piit79/SofleKeyboard/Sofle_RGB_v3/README.md

## Sofle RGB v3

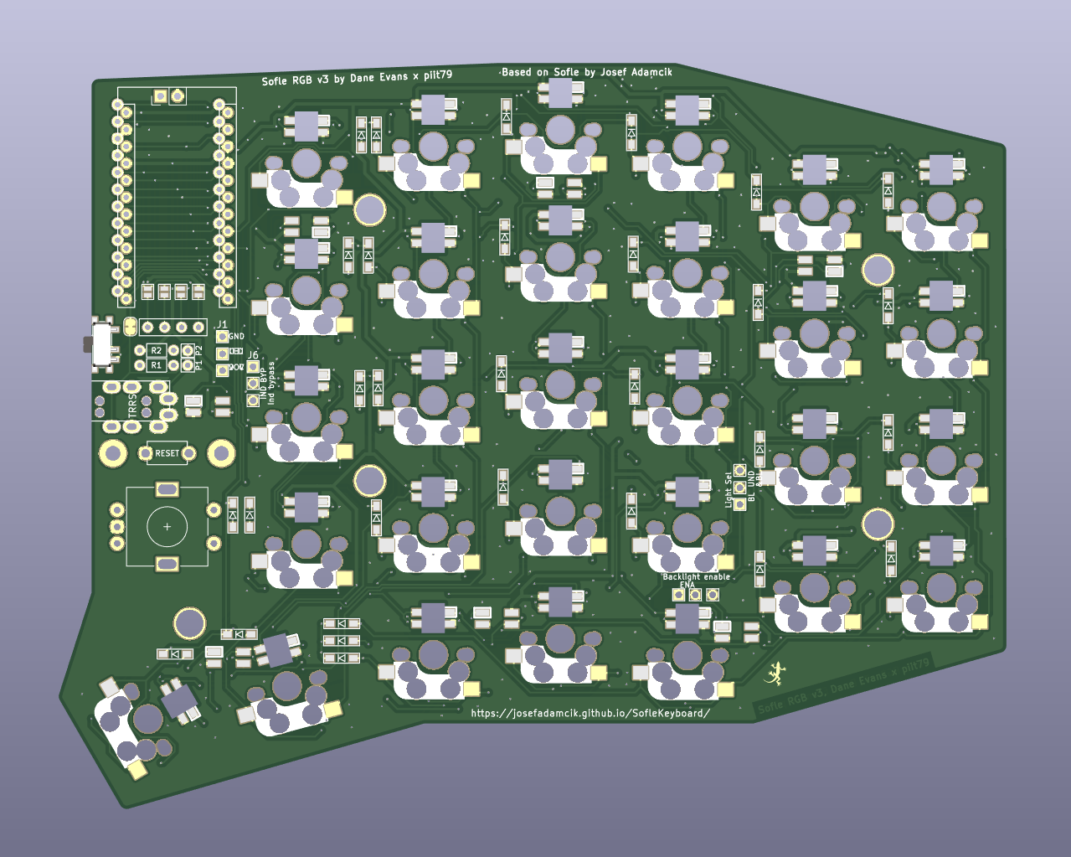
[picture p1: Sofle_RGB_v3/PCB/SofleKeyboard_RGB_v3.png]
Sofle RGB v3 PCB


This is a variation of the Sofle RGB with the more aggressive "pinky stagger" of the Sofle v2, plus a few other modifications:

* Support for a SMD power switch
* Battery connector next to the controller footprint (intended for a small battery that fits underneath the controller)
