piit79/SofleKeyboard/Sofle_RGB_v3/Case/Acrylic/README.md

## Acrylic Case for the Sofle RGB V3

There are 2 main constructions of the case:

  * Partial, with gaps between the switch plates and PCBs, and/or PCBs and bottom plates
  * Full sandwich with no gaps

Each construction can also be made in two variants:

  * Standard
  * Tenting - with bottom plates that have lugs for tenting legs

### Partial Case

  * 3 mm acrylic [switch plates](https://github.com/piit79/SofleKeyboard/blob/sofle_rgb_v3/Sofle_RGB_v3/Case/Acrylic/SofleKeyboard_RGB_v3-switch-plates.svg) (with 2 or 3 mm acrylic covers)
  * Optional 2 mm switch plate foams (same file as for the switch plates, just without the covers)
  * 3 mm acrylic bottom plates - [standard](https://github.com/piit79/SofleKeyboard/blob/sofle_rgb_v3/Sofle_RGB_v3/Case/Acrylic/SofleKeyboard_RGB_v3-bottom-standard-plates-screws.svg) or [tenting](https://github.com/piit79/SofleKeyboard/blob/sofle_rgb_v3/Sofle_RGB_v3/Case/Acrylic/SofleKeyboard_RGB_v3-bottom-tenting-plates-screws.svg)

Required mounting hardware:

  * 10x M2x6 mm brass standoffs (to go between switch and bottom plates)
  * 4x M2x10 mm brass standoffs (for the acrylic covers)
  * 28x M2x6 mm screws

### Full Sandwich Case

  * 3 mm acrylic [switch plates](https://github.com/piit79/SofleKeyboard/blob/sofle_rgb_v3/Sofle_RGB_v3/Case/Acrylic/SofleKeyboard_RGB_v3-switch-plates.svg) (with 2 or 3 mm acrylic covers)
  * 2 mm switch plate foams or acrylic upper mid plates (same file as for the switch plates, just without the covers)
  * 2 or 3 mm bottom mid layer (foam or acrylic) - [with battery cutouts](https://github.com/piit79/SofleKeyboard/blob/sofle_rgb_v3/Sofle_RGB_v3/Case/Acrylic/SofleKeyboard_RGB_v3-mid-plates-battery.svg) or [without them](https://github.com/piit79/SofleKeyboard/blob/sofle_rgb_v3/Sofle_RGB_v3/Case/Acrylic/SofleKeyboard_RGB_v3-mid-plates-no-battery.svg)
  * 3 mm acrylic bottom plates - [standard](https://github.com/piit79/SofleKeyboard/blob/sofle_rgb_v3/Sofle_RGB_v3/Case/Acrylic/SofleKeyboard_RGB_v3-bottom-standard-plates-inserts.svg) or [tenting](https://github.com/piit79/SofleKeyboard/blob/sofle_rgb_v3/Sofle_RGB_v3/Case/Acrylic/SofleKeyboard_RGB_v3-bottom-tenting-plates-inserts.svg)

The bottom mid layer has two variants - with a cutout for the battery underneath the controller (for 3 mm acrylic) and without it (for 2 mm acrylic).

Required mounting hardware:

  * 10x M2x3Lx3.5D mm heat-set brass threaded inserts (3 mm long, 3.5 mm diameter; for the bottom plates)
  * 4x M2x10 mm brass standoffs (for the acrylic covers)
  * 10x M2x12 mm screws (these go through the switch plates all the way into the bottom plates)
  * 8x M2x6 mm screws (for the acrylic covers)
