piit79/SofleKeyboard/(list of files, cad)

Other CAD files:
Sofle_Choc_v2.2/Case/Sofle_Choc_v2.2_acrylic_bottom.dxf
Sofle_RGB_v3/Case/Acrylic_Cover.dxf
Sofle_RGB_v3/Case/PCBBottom/SofleKeyboard_RGB_v3_Bottom.dxf
Sofle_Choc_v2.2/Case/Sofle_Choc_v2.2_acrylic_cover.dxf
Sofle_RGB_v3/Case/Acrylic/SofleKeyboard_RGB_v3-mid-plates-no-battery.dxf
Sofle_RGB_v3/Case/Acrylic/SofleKeyboard_RGB_v3-switch-plates.dxf
Sofle_RGB_v3/Case/Acrylic/SofleKeyboard_RGB_v3-bottom-tenting-plates-inserts.dxf
Sofle_RGB_v3/Case/Acrylic/SofleKeyboard_RGB_v3-mid-plates-battery.dxf
Sofle_RGB_v3/Case/Acrylic/SofleKeyboard_RGB_v3-bottom-standard-plates-inserts.dxf
Sofle_RGB_v3/Case/Acrylic/SofleKeyboard_RGB_v3-bottom-standard-plates-screws.dxf
Sofle_RGB_v3/Case/Acrylic/SofleKeyboard_RGB_v3-bottom-tenting-plates-screws.dxf
