piit79/SofleKeyboard/(list of files, drawings)

Other design files:
Sofle_Choc_v2.2/PCB/SofleKeyboard.dsn
