piit79/SofleKeyboard/Sofle_RGB_v3/PCB/SofleKeyboard_RGB_v3.kicad_pcb

## KiCad design Sofle_RGB_v3/PCB/SofleKeyboard_RGB_v3.kicad_pcb (2024-08-11)

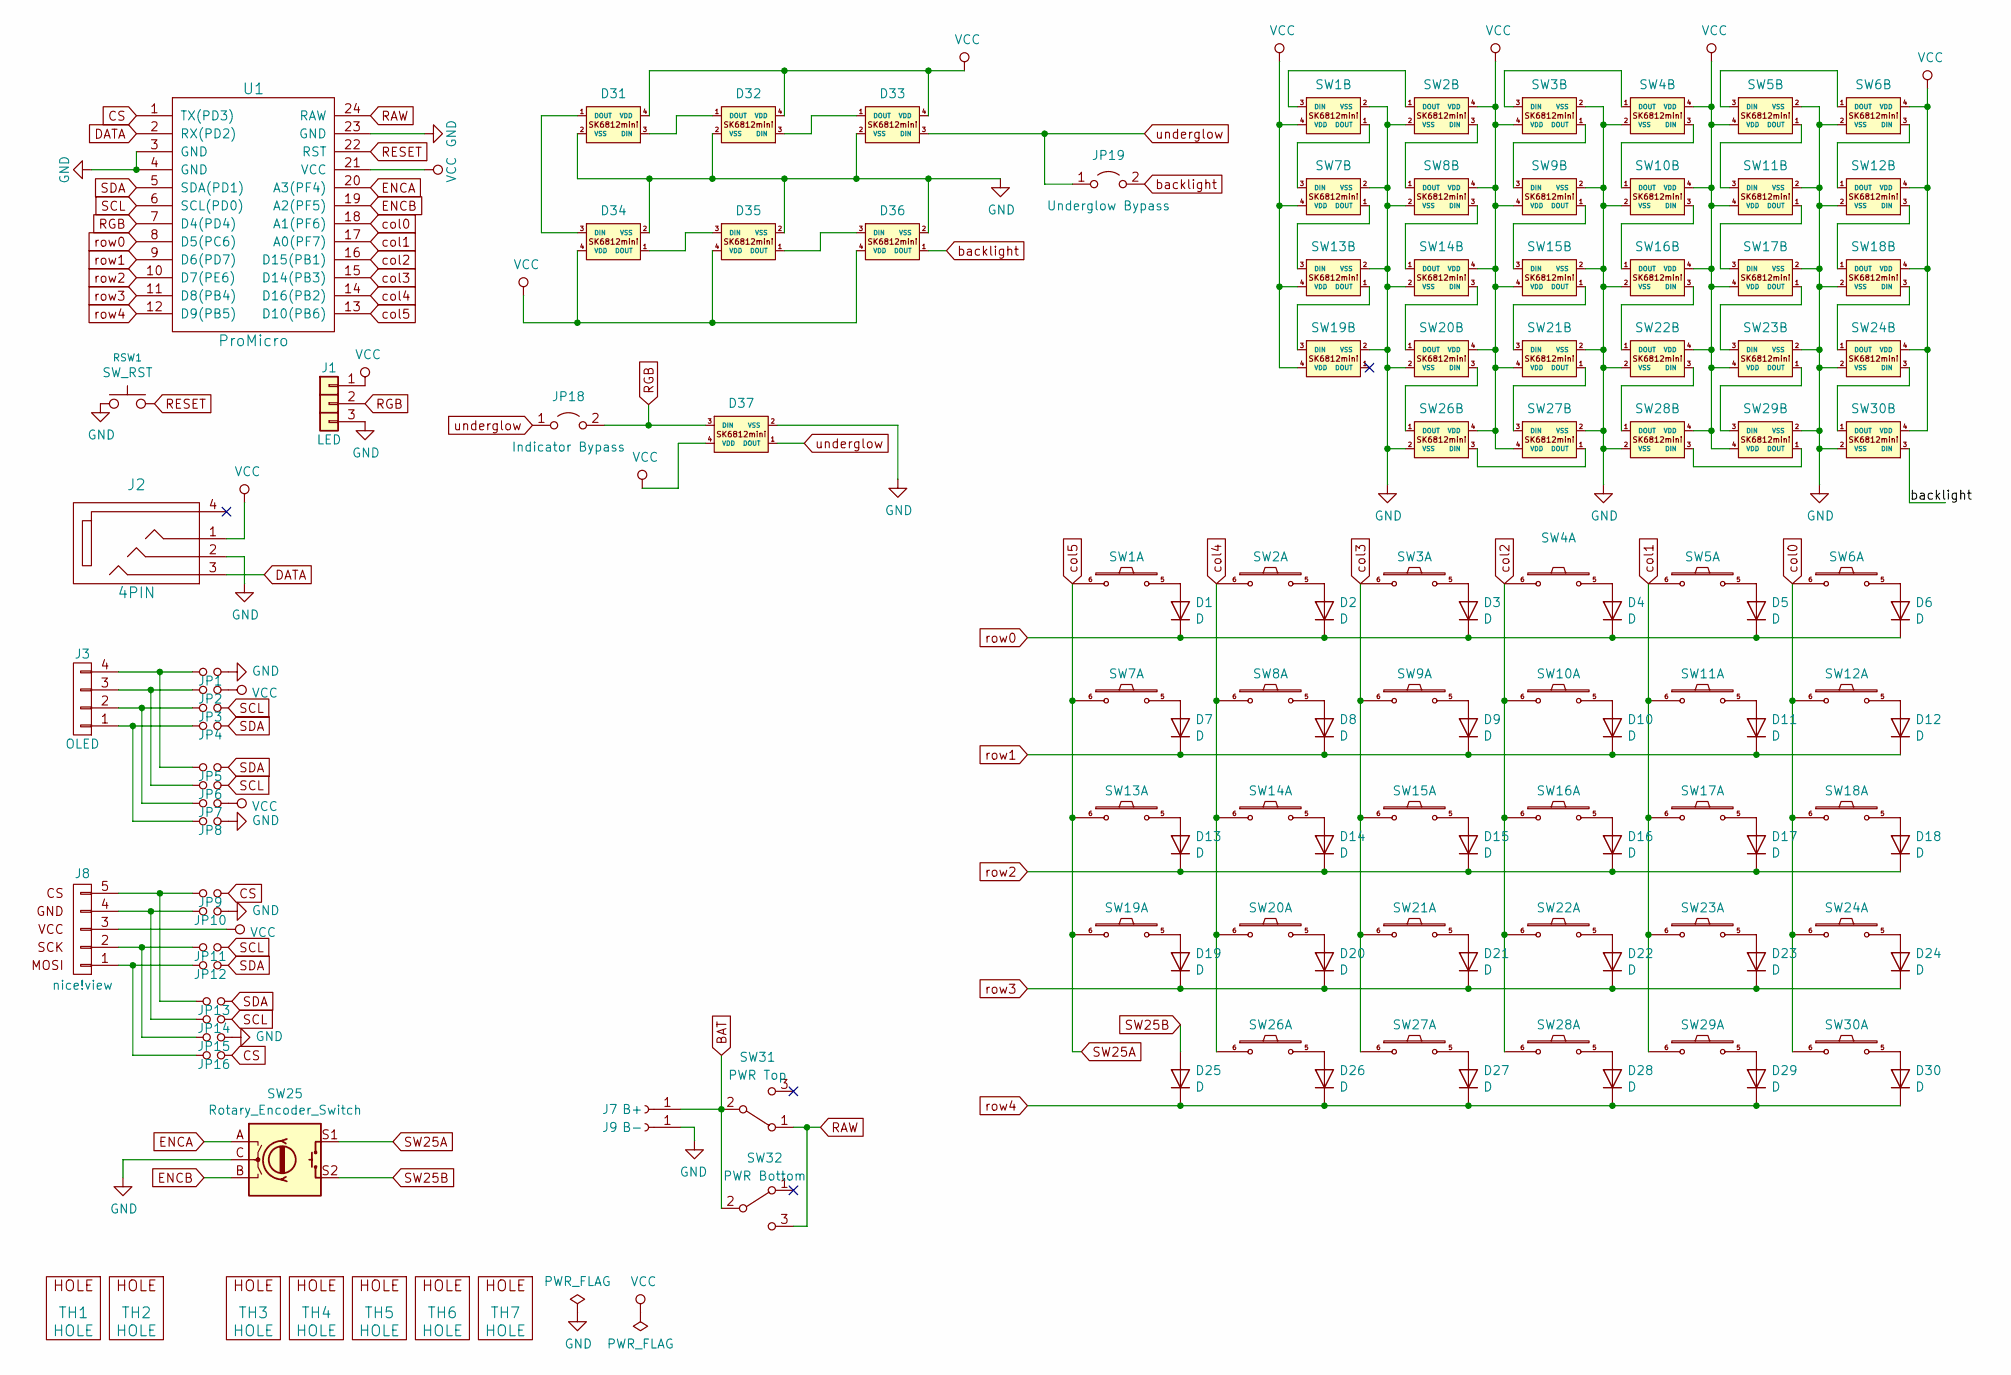
[picture p2: schematic SofleKeyboard_RGB_v3.kicad_sch]

Parts:
D1, D2, D3, D4, D5, D6, D7, D8, D9, D10, D11, D12, D13, D14, D15, D16, D17, D18, D19, D20, D21, D22, D23, D24, D25, D26, D27, D28, D29, D30: D; SOD-223_with_cutout
D31, D32, D33, D34, D35, D36, D37: LED_sk2812_SM; SK6812MINI_underglow_with_cutout
J1: LED
J2: 4PIN; PJ-320A_double_sided_with_cutouts
J3: OLED; OLED_4Pin
J7: B+; 1pin_conn
J8: nice!view; niceview_5Pin
J9: B-; 1pin_conn
JP1, JP2, JP3, JP4, JP5, JP6, JP7, JP8, JP9, JP10, JP11, JP12, JP13, JP14, JP15, JP16: Jumper_NO_Small; Jumper
JP18: Indicator Bypass; SolderJumper-2_P1.3mm_Open_TrianglePad1.0x1.5mm
JP19: Underglow Bypass; SolderJumper-2_P1.3mm_Open_TrianglePad1.0x1.5mm
RSW1: SW_RST; TACT_SWITCH_TVBP06
SW1, SW2, SW3, SW4, SW5, SW6, SW7, SW8, SW9, SW10, SW11, SW12, SW13, SW14, SW15, SW16, SW17, SW18, SW19, SW20, SW21, SW22, SW23, SW24, SW26, SW27, SW28, SW29, SW30: SW_PUSH-MX_W_LED; SK6812MINI_and_cherry_with_cutouts
SW25: Rotary_Encoder_Switch; RotaryEncoder_Alps_EC11E-Switch_Vertical_H20mm-keebio_modif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
SW31: PWR Top; SW_SPDT_PCM12
SW32: PWR Bottom; SW_SPDT_PCM12
TH1, TH2: HOLE; M2_HOLE_PCB
TH3, TH4, TH5, TH6, TH7: HOLE; HOLE_M2_TH
U1: ProMicro; ProMicro_with_cutouts

Connections:
BAT: J7.1, SW31.2 (B), SW32.2 (B)
CS: JP9.2, JP16.2, U1.1 (TX(PD3))
DATA: J2.3, U1.2 (RX(PD2))
ENCA: SW25.A, U1.20 (A3(PF4))
ENCB: SW25.B, U1.19 (A2(PF5))
GND: D31.2 (VSS), D32.2 (VSS), D33.2 (VSS), D34.2 (VSS), D35.2 (VSS), D36.2 (VSS), D37.2 (VSS), J1.3, J2.2, J9.1, JP1.2, JP8.2, JP10.2, JP15.2, RSW1.1, SW1.2 (VSS), SW2.2 (VSS), SW3.2 (VSS), SW4.2 (VSS), SW5.2 (VSS), SW6.2 (VSS), SW7.2 (VSS), SW8.2 (VSS), SW9.2 (VSS), SW10.2 (VSS), SW11.2 (VSS), SW12.2 (VSS), SW13.2 (VSS), SW14.2 (VSS), SW15.2 (VSS), SW16.2 (VSS), SW17.2 (VSS), SW18.2 (VSS), SW19.2 (VSS), SW20.2 (VSS), SW21.2 (VSS), SW22.2 (VSS), SW23.2 (VSS), SW24.2 (VSS), SW25.C, SW26.2 (VSS), SW27.2 (VSS), SW28.2 (VSS), SW29.2 (VSS), SW30.2 (VSS), U1.3 (GND), U1.4 (GND), U1.23 (GND)
unnamed: D1.2 (A), SW1.5
unnamed: D2.2 (A), SW2.5
unnamed: D3.2 (A), SW3.5
unnamed: D4.2 (A), SW4.5
unnamed: D5.2 (A), SW5.5
unnamed: D6.2 (A), SW6.5
unnamed: D7.2 (A), SW7.5
unnamed: D8.2 (A), SW8.5
unnamed: D9.2 (A), SW9.5
unnamed: D10.2 (A), SW10.5
unnamed: D11.2 (A), SW11.5
unnamed: D12.2 (A), SW12.5
unnamed: D13.2 (A), SW13.5
unnamed: D14.2 (A), SW14.5
unnamed: D15.2 (A), SW15.5
unnamed: D16.2 (A), SW16.5
unnamed: D17.2 (A), SW17.5
unnamed: D18.2 (A), SW18.5
unnamed: D19.2 (A), SW19.5
unnamed: D20.2 (A), SW20.5
unnamed: D21.2 (A), SW21.5
unnamed: D22.2 (A), SW22.5
unnamed: D23.2 (A), SW23.5
unnamed: D24.2 (A), SW24.5
unnamed: D26.2 (A), SW26.5
unnamed: D27.2 (A), SW27.5
unnamed: D28.2 (A), SW28.5
unnamed: D29.2 (A), SW29.5
unnamed: D30.2 (A), SW30.5
unnamed: D31.3 (DIN), D32.1 (DOUT)
unnamed: D31.1 (DOUT), D34.3 (DIN)
unnamed: D32.3 (DIN), D33.1 (DOUT)
unnamed: D34.1 (DOUT), D35.3 (DIN)
unnamed: D35.1 (DOUT), D36.3 (DIN)
unnamed: J3.1, JP4.1, JP8.1
unnamed: J3.2, JP3.1, JP7.1
unnamed: J3.3, JP2.1, JP6.1
unnamed: J3.4, JP1.1, JP5.1
unnamed: J8.1, JP12.1, JP16.1
unnamed: J8.2, JP11.1, JP15.1
unnamed: J8.4, JP10.1, JP14.1
unnamed: J8.5, JP9.1, JP13.1
unnamed: SW1.3 (DIN), SW2.1 (DOUT)
unnamed: SW1.1 (DOUT), SW7.3 (DIN)
unnamed: SW2.3 (DIN), SW8.1 (DOUT)
unnamed: SW3.3 (DIN), SW4.1 (DOUT)
unnamed: SW3.1 (DOUT), SW9.3 (DIN)
unnamed: SW5.3 (DIN), SW6.1 (DOUT)
unnamed: SW10.3 (DIN), SW16.1 (DOUT)
unnamed: SW4.3 (DIN), SW10.1 (DOUT)
unnamed: SW5.1 (DOUT), SW11.3 (DIN)
unnamed: SW11.1 (DOUT), SW17.3 (DIN)
unnamed: SW12.3 (DIN), SW18.1 (DOUT)
unnamed: SW6.3 (DIN), SW12.1 (DOUT)
unnamed: SW7.1 (DOUT), SW13.3 (DIN)
unnamed: SW13.1 (DOUT), SW19.3 (DIN)
unnamed: SW14.3 (DIN), SW20.1 (DOUT)
unnamed: SW8.3 (DIN), SW14.1 (DOUT)
unnamed: SW9.1 (DOUT), SW15.3 (DIN)
unnamed: SW15.1 (DOUT), SW21.3 (DIN)
unnamed: SW16.3 (DIN), SW22.1 (DOUT)
unnamed: SW17.1 (DOUT), SW23.3 (DIN)
unnamed: SW18.3 (DIN), SW24.1 (DOUT)
unnamed: SW20.3 (DIN), SW26.1 (DOUT)
unnamed: SW21.1 (DOUT), SW27.3 (DIN)
unnamed: SW22.3 (DIN), SW28.1 (DOUT)
unnamed: SW23.1 (DOUT), SW29.3 (DIN)
unnamed: SW24.3 (DIN), SW30.1 (DOUT)
unnamed: SW26.3 (DIN), SW27.1 (DOUT)
unnamed: SW28.3 (DIN), SW29.1 (DOUT)
RAW: SW31.1 (A), SW32.3 (C), U1.24 (RAW)
RESET: RSW1.2, U1.22 (RST)
RGB: D37.3 (DIN), J1.2, JP18.2 (B), U1.7 (D4(PD4))
SCL: JP3.2, JP6.2, JP11.2, JP14.2, U1.6 (SCL(PD0))
SDA: JP4.2, JP5.2, JP12.2, JP13.2, U1.5 (SDA(PD1))
SW25A: SW1.6, SW7.6, SW13.6, SW19.6, SW25.S1, U1.13 (D10(PB6))
SW25B: D25.2 (A), SW25.S2
VCC: D31.4 (VDD), D32.4 (VDD), D33.4 (VDD), D34.4 (VDD), D35.4 (VDD), D36.4 (VDD), D37.4 (VDD), J1.1, J2.1, J8.3, JP2.2, JP7.2, SW1.4 (VDD), SW2.4 (VDD), SW3.4 (VDD), SW4.4 (VDD), SW5.4 (VDD), SW6.4 (VDD), SW7.4 (VDD), SW8.4 (VDD), SW9.4 (VDD), SW10.4 (VDD), SW11.4 (VDD), SW12.4 (VDD), SW13.4 (VDD), SW14.4 (VDD), SW15.4 (VDD), SW16.4 (VDD), SW17.4 (VDD), SW18.4 (VDD), SW19.4 (VDD), SW20.4 (VDD), SW21.4 (VDD), SW22.4 (VDD), SW23.4 (VDD), SW24.4 (VDD), SW26.4 (VDD), SW27.4 (VDD), SW28.4 (VDD), SW29.4 (VDD), SW30.4 (VDD), U1.21 (VCC)
backlight: D36.1 (DOUT), JP19.2 (B), SW30.3 (DIN)
col0: SW6.6, SW12.6, SW18.6, SW24.6, SW30.6, U1.18 (A1(PF6))
col1: SW5.6, SW11.6, SW17.6, SW23.6, SW29.6, U1.17 (A0(PF7))
col2: SW4.6, SW10.6, SW16.6, SW22.6, SW28.6, U1.16 (D15(PB1))
col3: SW3.6, SW9.6, SW15.6, SW21.6, SW27.6, U1.15 (D14(PB3))
col4: SW2.6, SW8.6, SW14.6, SW20.6, SW26.6, U1.14 (D16(PB2))
row0: D1.1 (K), D2.1 (K), D3.1 (K), D4.1 (K), D5.1 (K), D6.1 (K), U1.8 (D5(PC6))
row1: D7.1 (K), D8.1 (K), D9.1 (K), D10.1 (K), D11.1 (K), D12.1 (K), U1.9 (D6(PD7))
row2: D13.1 (K), D14.1 (K), D15.1 (K), D16.1 (K), D17.1 (K), D18.1 (K), U1.10 (D7(PE6))
row3: D19.1 (K), D20.1 (K), D21.1 (K), D22.1 (K), D23.1 (K), D24.1 (K), U1.11 (D8(PB4))
row4: D25.1 (K), D26.1 (K), D27.1 (K), D28.1 (K), D29.1 (K), D30.1 (K), U1.12 (D9(PB5))
underglow: D33.3 (DIN), D37.1 (DOUT), JP18.1 (A), JP19.1 (A)

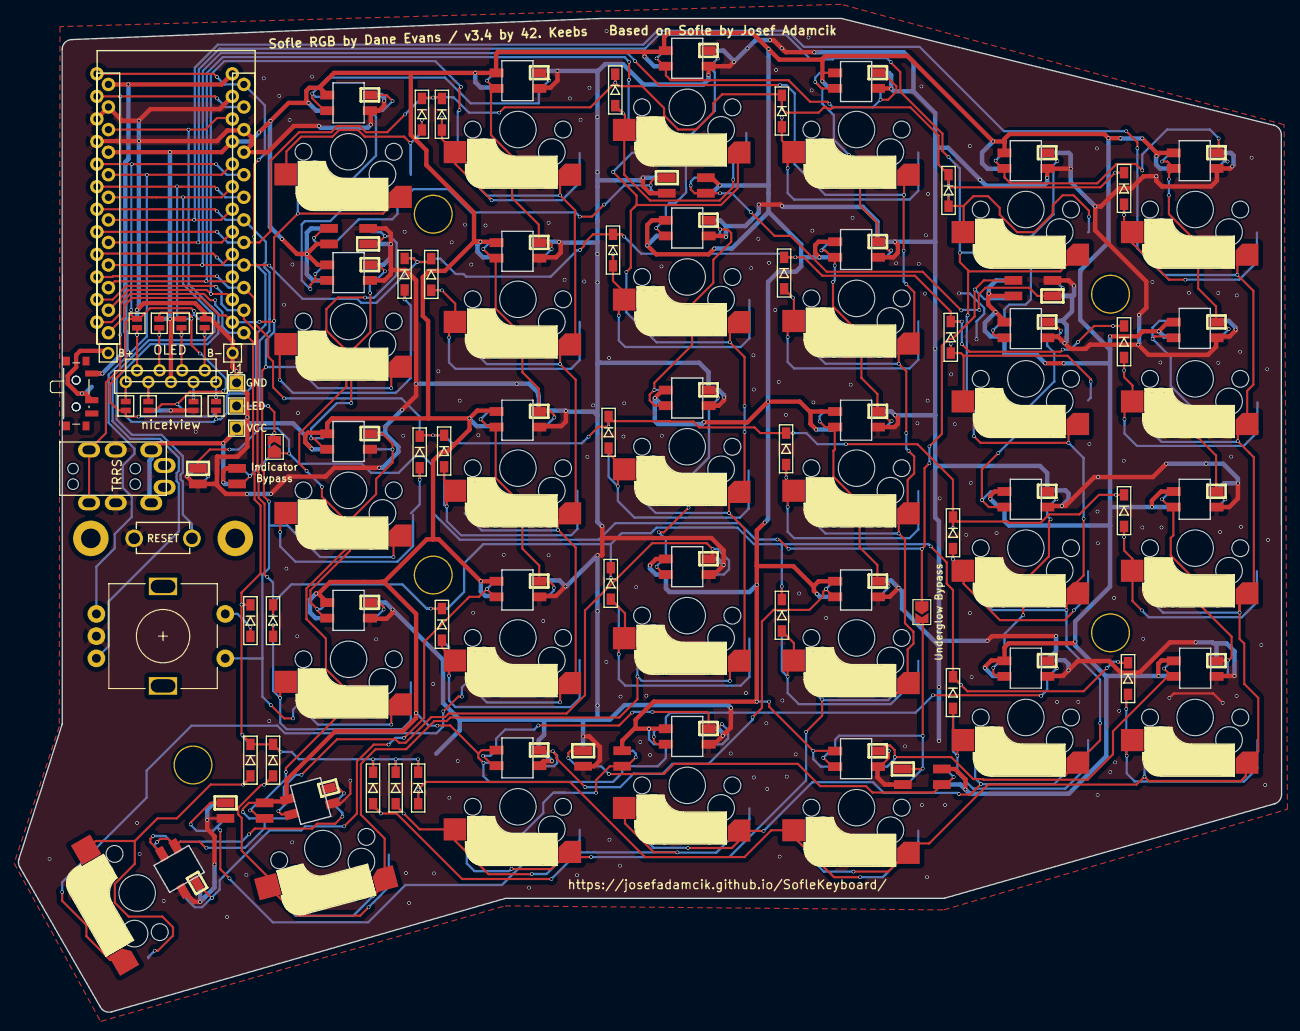
[picture p3: board SofleKeyboard_RGB_v3.kicad_pcb from above]

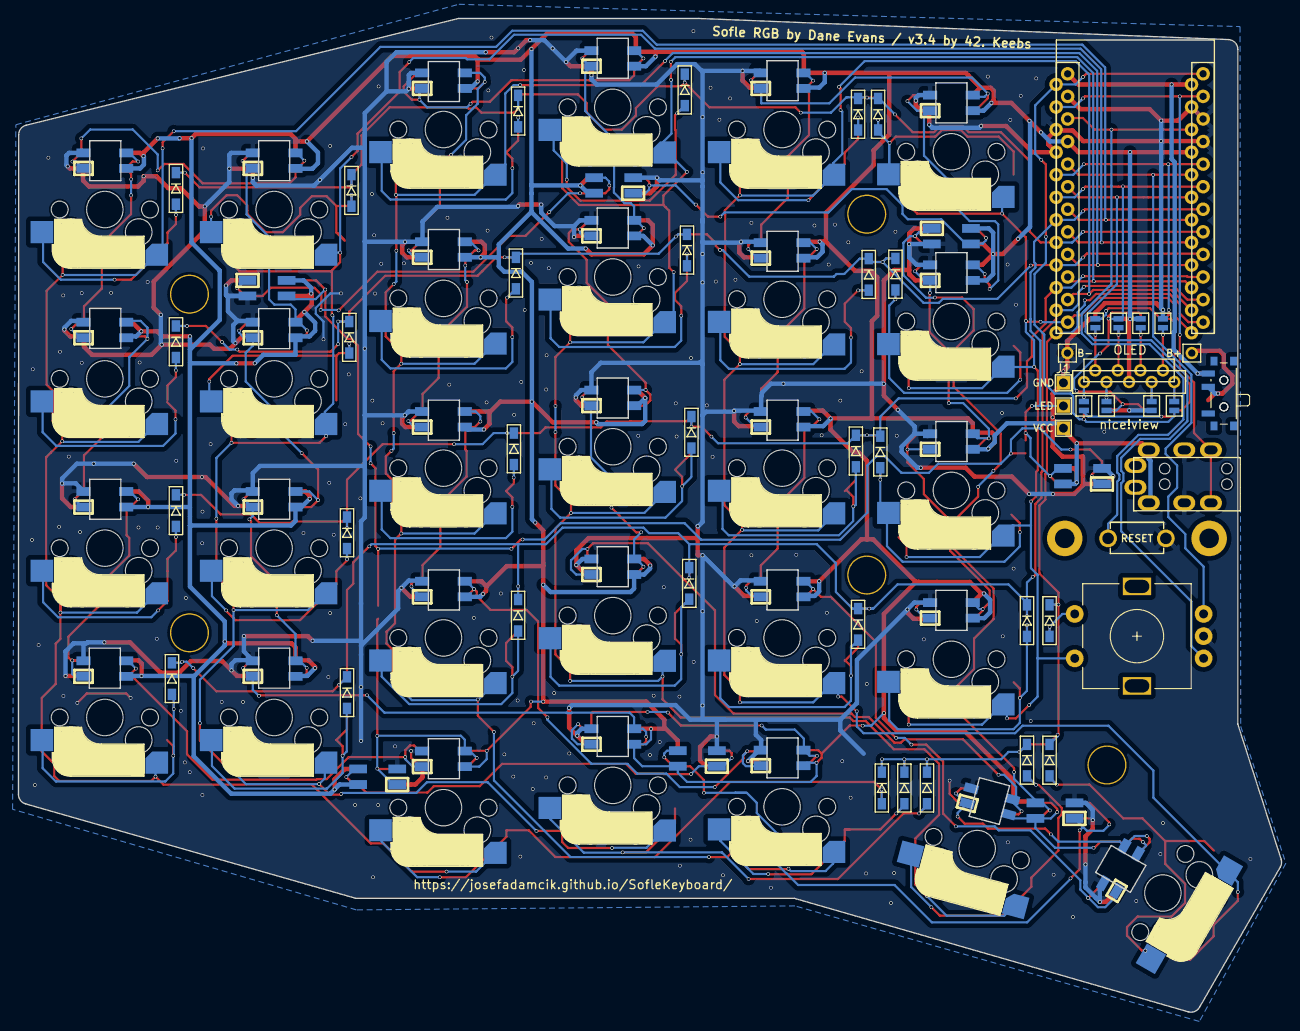
[picture p4: board SofleKeyboard_RGB_v3.kicad_pcb from below]

Board: 2 copper layers, 142.1 x 111.8 mm, 102 parts (10 on the bottom side), 96 nets.
