piit79/SofleKeyboard/(commit log)

2023-02-07 Add Sofle Choc v2.2 with power switch, battery footprint and modified outline
    [SofleKeyboard.dsn, SofleKeyboard.kicad_sch, SofleKeyboardTopPlate.kicad_pcb, Sofle_Choc_v2.2_acrylic_bottom.dxf, Sofle_Choc_v2.2_acrylic_cover.dxf]
2023-02-07 Add Sofle RGB 'v3' variant with Sofle v2 pinky stagger
    [Acrylic_Cover.dxf, SofleKeyboard_RGB_v3-bottom.dxf, SofleKeyboard_RGB_v3-switch-plate.dxf, SofleKeyboard_RGB_v3.kicad_pcb, SofleKeyboard_RGB_v3.kicad_sch, SofleKeyboard_RGB_v3_Bottom.dxf, SofleKeyboard_RGB_v3_Bottom.kicad_pcb, SofleKeyboard_RGB_v3_Top.kicad_pcb]
2024-08-07 Sofle RGB V3.2 with native nice!view support
    [SofleKeyboard_RGB_v3.kicad_pcb, SofleKeyboard_RGB_v3.kicad_sch]
2024-08-07 Update Sofle RGB V3 plates
    [SofleKeyboard_RGB_v3_Top.kicad_pcb]
2024-08-11 Add various footprints with cutouts
2024-08-11 Sofle RGB V3.4
    * Fix missing connection between underglow and backlight
    [SofleKeyboard_RGB_v3.kicad_pcb, SofleKeyboard_RGB_v3.kicad_sch]
2024-12-11 Update the case for Sofle RGB V3
    Includes partial and full sandwich cases
    in standard and tenting versions
    [SofleKeyboard_RGB_v3-bottom-standard-plates-inserts.dxf, SofleKeyboard_RGB_v3-bottom-standard-plates-screws.dxf, SofleKeyboard_RGB_v3-bottom-tenting-plates-inserts.dxf, SofleKeyboard_RGB_v3-bottom-tenting-plates-screws.dxf, SofleKeyboard_RGB_v3-bottom.dxf, SofleKeyboard_RGB_v3-mid-plates-battery.dxf, SofleKeyboard_RGB_v3-mid-plates-no-battery.dxf, SofleKeyboard_RGB_v3-switch-plate.dxf]
2024-12-11 Update gerbers for the Sofle RGB V3
